spel-uchile/CAD_SUCHAI_II/Insterstage_panels/CAD/GomSpace CAD Disclaimer.pdf

© 2015 Gomspace Aps | 1

CAD Model Disclaimer

This

is

an

official

CAD

model

prepared

by

GomSpace

for

customer

use

in

an

early
NanoSatellite

design

phase.

The

presented

CAD

models

depict

a

specific
configuration

and

production

batch

of

the

specific

product

and

should

be

used

with
care.

GomSpace

accepts no

liability

for

the

content

of

the

CAD

models

publicly
available,

or

for

the

consequences

of

specific

implementation

or

use

of

the

CAD
models.

The

user

of

the

CAD

model

holds

responsibility

for

use

of

all

CAD

models
from

GomSpace

website,

regardless

of

the

support

provided

by

GomSpace

staff

on

a
regular

support

basis.

GomSpace

reserves

the

right

to

update

hardware

on

any
system

and

not

update

the

CAD

model

with

changes

immediately.

The

company
accepts

no

liability

for

faulty

design

work

done

based

on

the

CAD

models
downloaded

from

the

website.

For

more

information

contact

GomSpace

at

Info@gomspace.com
