spel-uchile/CAD_SUCHAI_II/CAD_Cubesat_3U.pdf

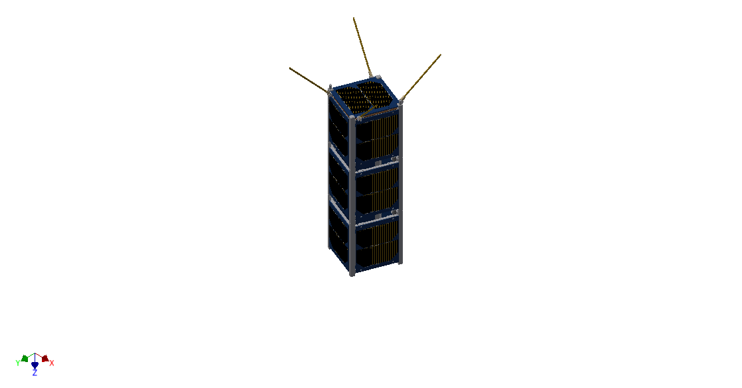
[picture p1: page 1]
