spel-uchile/CAD_SUCHAI_II/Structure/CAD/3U STS Export.jpg

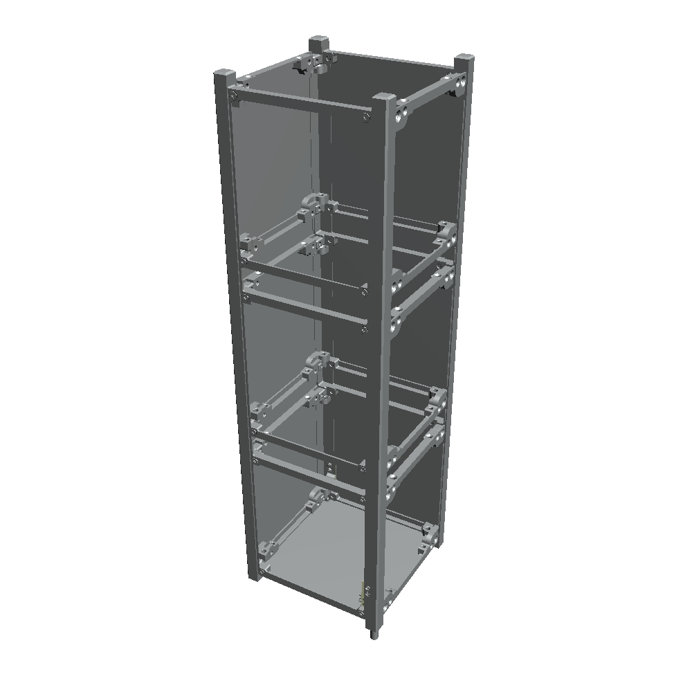
Structure/CAD/3U STS Export.jpg
