spel-uchile/CAD_SUCHAI_II/Insterstage_panels/CAD/GOMX-Interstage-B.stp

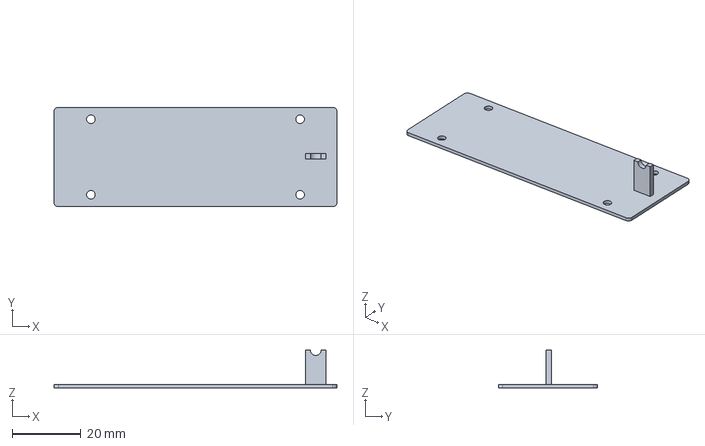
[picture p3: CAD file, 2017-08-24]
Insterstage_panels/CAD/GOMX-Interstage-B.stp
82.5 x 29.0 x 11.0 mm
