spel-uchile/CAD_SUCHAI_II/Nanopower_BP4/CAD/bp4-2.0.stp

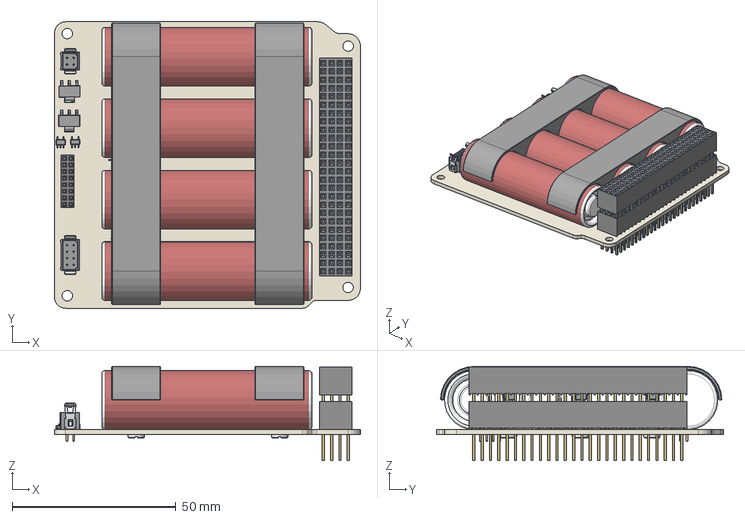
[picture p5: CAD file, 2017-08-24]
Nanopower_BP4/CAD/bp4-2.0.stp
93.4 x 87.4 x 28.7 mm
