spel-uchile/CAD_SUCHAI_II/Structure_1U/ISIS CubeSat STS PC104 Skeleton.stp

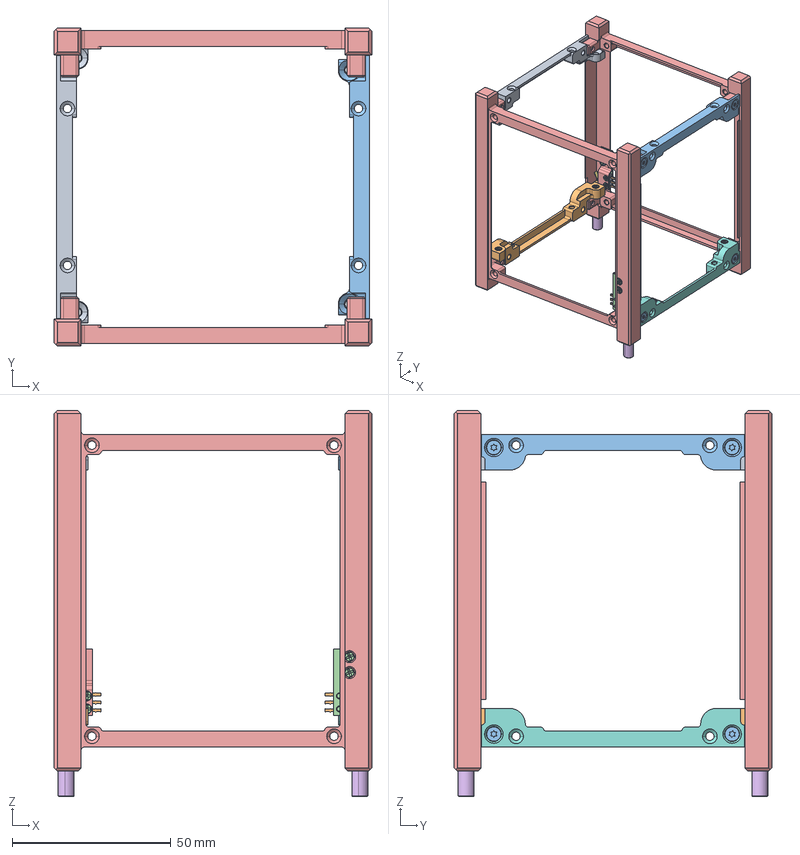
[picture p7: CAD file, 2017-08-24]
Structure_1U/ISIS CubeSat STS PC104 Skeleton.stp
100.0 x 100.0 x 121.5 mm
KILL_SWITCH_BODY x 2
KILL_SWITCH_PINS x 2
SCREW_M2_5X6 x 8
BRACKET_KS_007B x 2
BRACKET_KS_007A x 2
BUSJE_001 x 2
KILL_SWITCH_LEVER x 2
KILL_SWITCH_SWITCH x 2
SPRING_02 x 2
KILL_SWITCH_PIN x 2
NUT_M1_6 x 4
SCREW_M1_6X4 x 8
SIDE_FRAME_007 x 2
HELICOIL_M3_1_5D x 4
REVD_02-1_RIB_D
REVE_02-1_RIB_E
REVE_02-1_RIB_C
REVD_02-1_RIB_F
