spel-uchile/CAD_SUCHAI_II/Insterstage_panels/CAD/GOMX-Interstage-A.stp

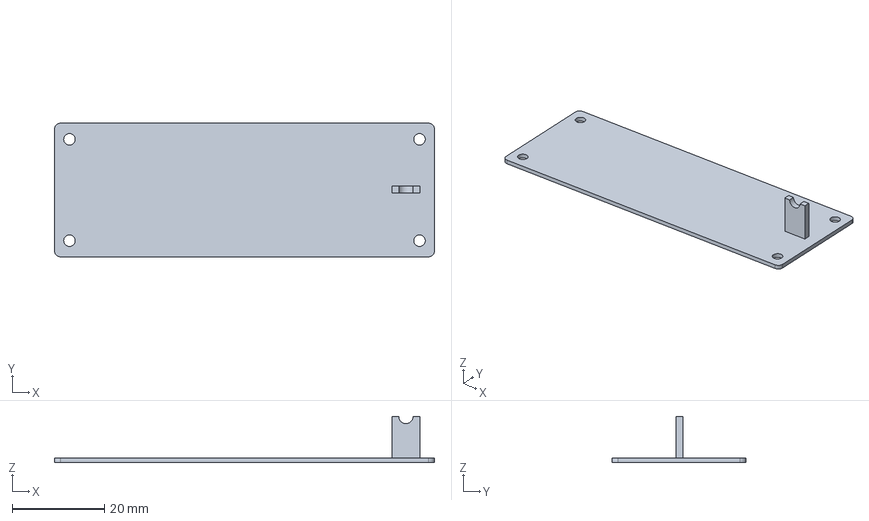
[picture p8: CAD file, 2017-08-24]
Insterstage_panels/CAD/GOMX-Interstage-A.stp
82.5 x 29.0 x 10.0 mm
