spel-uchile/CAD_SUCHAI_II/Nanocom_ant430/CAD/Sub_NanoCom_ANT430.stp/nanocom-ant430-deployed.stp

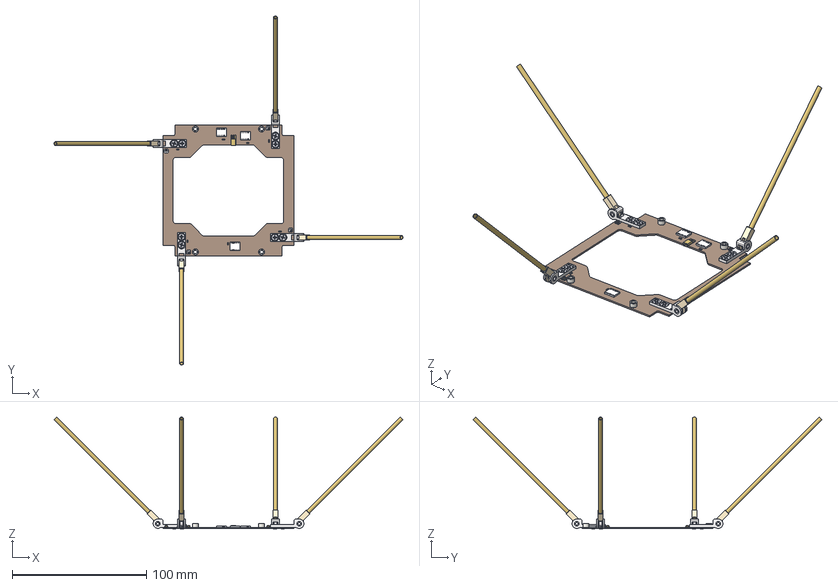
[picture p9: CAD file, 2017-08-24]
Nanocom_ant430/CAD/Sub_NanoCom_ANT430.stp/nanocom-ant430-deployed.stp
260.2 x 260.2 x 83.5 mm
panel-top
antenna-bracket-top-2 x 4
antenna-fork-top-1 x 4
antenna-fork-top-bush x 4
antenna-100 x 4
DIN EN ISO 7046-1 H M2,5 x 6 - 4.8 - H x 4
DIN EN ISO 7046-1 H M2,5 x 6 - 4.8 - H_1 x 4
hirose-ufl x 4
qba07 x 3
ssmcx-flat
R0603 x 7
2.5x4.5x3.0mm-spacer x 4
