spel-uchile/CAD_SUCHAI_II/Insterstage_panels/CAD/GOMX-Interstage-FPP.stp

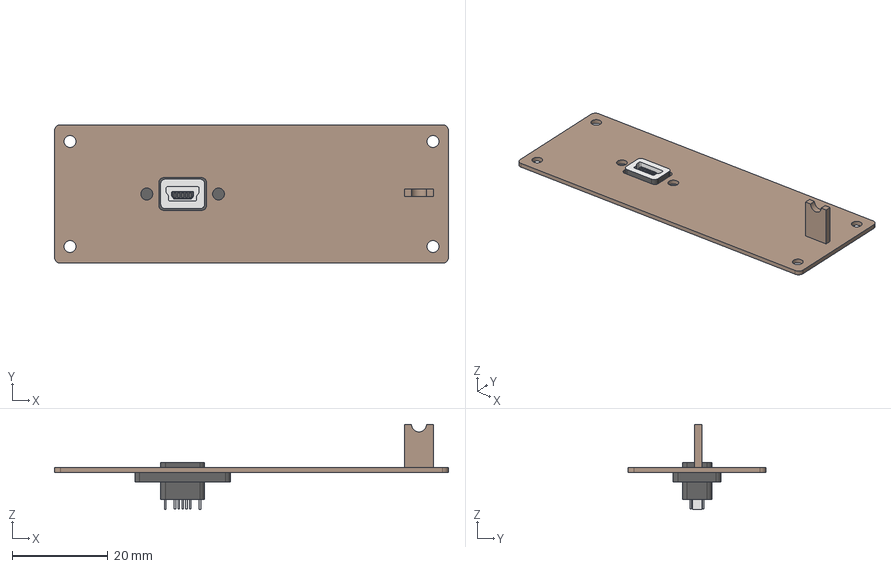
[picture p10: CAD file, 2017-08-24]
Insterstage_panels/CAD/GOMX-Interstage-FPP.stp
82.5 x 29.0 x 17.8 mm
fpp
User Library-USB-B-Vert-MINI
