spel-uchile/CAD_SUCHAI_II/(list of files, cad)

Other CAD files:
CAD_Cubesat_3U.iam
Insterstage_panels/CAD/GOMX-Interstage-A.ipt
Insterstage_panels/CAD/GOMX-Interstage-B.ipt
Insterstage_panels/CAD/GOMX-Interstage-FPP.iam
Insterstage_panels/CAD/OldVersions/GOMX-Interstage-FPP.0001.iam
Insterstage_panels/CAD/User Library-USB-B-Vert-MINI.ipt
Insterstage_panels/CAD/fpp.ipt
NanoDock/CAD/20140506-063843-14522585.ipt
NanoDock/CAD/457276448.iam
NanoDock/CAD/457276576.iam
NanoDock/CAD/457276704.iam
NanoDock/CAD/457276832.iam
NanoDock/CAD/457276960.iam
NanoDock/CAD/457277088.iam
NanoDock/CAD/457277216.iam
NanoDock/CAD/457277344.iam
NanoDock/CAD/457277600.iam
NanoDock/CAD/457277728.iam
NanoDock/CAD/457277856.iam
NanoDock/CAD/457277984.iam
NanoDock/CAD/457278112.iam
NanoDock/CAD/457278624.iam
NanoDock/CAD/457278752.iam
NanoDock/CAD/457278880.iam
NanoDock/CAD/532610471.iam
NanoDock/CAD/Board.ipt
NanoDock/CAD/C1.iam
NanoDock/CAD/C10.iam
NanoDock/CAD/C11.iam
NanoDock/CAD/C12.iam
NanoDock/CAD/C13.iam
NanoDock/CAD/C14.iam
NanoDock/CAD/C2.iam
NanoDock/CAD/C3.iam
NanoDock/CAD/C4.iam
NanoDock/CAD/C5.iam
NanoDock/CAD/C6.iam
NanoDock/CAD/C7.iam
NanoDock/CAD/C8.iam
NanoDock/CAD/C9.iam
NanoDock/CAD/Extruded.ipt
NanoDock/CAD/Extruded_1.ipt
NanoDock/CAD/Extruded_10.ipt
NanoDock/CAD/Extruded_11.ipt
NanoDock/CAD/Extruded_12.ipt
NanoDock/CAD/Extruded_13.ipt
NanoDock/CAD/Extruded_14.ipt
NanoDock/CAD/Extruded_15.ipt
NanoDock/CAD/Extruded_2.ipt
NanoDock/CAD/Extruded_3.ipt
NanoDock/CAD/Extruded_4.ipt
NanoDock/CAD/Extruded_5.ipt
NanoDock/CAD/Extruded_6.ipt
NanoDock/CAD/Extruded_7.ipt
NanoDock/CAD/Extruded_8.ipt
NanoDock/CAD/Extruded_9.ipt
NanoDock/CAD/H1.iam
NanoDock/CAD/H2.iam
NanoDock/CAD/L1.iam
NanoDock/CAD/L2.iam
NanoDock/CAD/Motherboard.iam
NanoDock/CAD/OldVersions/457276448.0002.iam
NanoDock/CAD/OldVersions/457276576.0002.iam
NanoDock/CAD/OldVersions/457276704.0002.iam
NanoDock/CAD/OldVersions/457276832.0002.iam
NanoDock/CAD/OldVersions/457276960.0002.iam
NanoDock/CAD/OldVersions/457277088.0002.iam
NanoDock/CAD/OldVersions/457277216.0002.iam
NanoDock/CAD/OldVersions/457277344.0002.iam
NanoDock/CAD/OldVersions/457277600.0002.iam
NanoDock/CAD/OldVersions/457277728.0002.iam
NanoDock/CAD/OldVersions/457277856.0002.iam
NanoDock/CAD/OldVersions/457277984.0002.iam
NanoDock/CAD/OldVersions/457278112.0002.iam
NanoDock/CAD/OldVersions/457278624.0002.iam
NanoDock/CAD/OldVersions/457278752.0002.iam
NanoDock/CAD/OldVersions/457278880.0002.iam
NanoDock/CAD/OldVersions/532610471.0002.iam
NanoDock/CAD/OldVersions/Board.0001.ipt
NanoDock/CAD/OldVersions/C1.0002.iam
NanoDock/CAD/OldVersions/C10.0002.iam
NanoDock/CAD/OldVersions/C11.0002.iam
NanoDock/CAD/OldVersions/C12.0002.iam
NanoDock/CAD/OldVersions/C13.0002.iam
NanoDock/CAD/OldVersions/C14.0002.iam
NanoDock/CAD/OldVersions/C2.0002.iam
NanoDock/CAD/OldVersions/C3.0002.iam
NanoDock/CAD/OldVersions/C4.0002.iam
NanoDock/CAD/OldVersions/C5.0002.iam
NanoDock/CAD/OldVersions/C6.0002.iam
NanoDock/CAD/OldVersions/C7.0002.iam
NanoDock/CAD/OldVersions/C8.0002.iam
NanoDock/CAD/OldVersions/C9.0002.iam
NanoDock/CAD/OldVersions/H1.0002.iam
NanoDock/CAD/OldVersions/H2.0002.iam
NanoDock/CAD/OldVersions/L1.0002.iam
NanoDock/CAD/OldVersions/L2.0002.iam
NanoDock/CAD/OldVersions/Motherboard.0002.iam
NanoDock/CAD/OldVersions/P1.0002.iam
NanoDock/CAD/OldVersions/P2.0002.iam
NanoDock/CAD/OldVersions/P3.0002.iam
NanoDock/CAD/OldVersions/P4.0002.iam
NanoDock/CAD/OldVersions/R1.0002.iam
NanoDock/CAD/OldVersions/R10.0002.iam
NanoDock/CAD/OldVersions/R11.0002.iam
NanoDock/CAD/OldVersions/R12.0002.iam
NanoDock/CAD/OldVersions/R13.0002.iam
NanoDock/CAD/OldVersions/R14.0002.iam
NanoDock/CAD/OldVersions/R15.0002.iam
NanoDock/CAD/OldVersions/R16.0002.iam
NanoDock/CAD/OldVersions/R17.0002.iam
NanoDock/CAD/OldVersions/R18.0002.iam
NanoDock/CAD/OldVersions/R19.0002.iam
NanoDock/CAD/OldVersions/R2.0002.iam
NanoDock/CAD/OldVersions/R20.0002.iam
NanoDock/CAD/OldVersions/R21.0002.iam
NanoDock/CAD/OldVersions/R22.0002.iam
NanoDock/CAD/OldVersions/R23.0002.iam
NanoDock/CAD/OldVersions/R24.0002.iam
NanoDock/CAD/OldVersions/R25.0002.iam
NanoDock/CAD/OldVersions/R26.0002.iam
NanoDock/CAD/OldVersions/R27.0002.iam
NanoDock/CAD/OldVersions/R28.0002.iam
NanoDock/CAD/OldVersions/R29.0002.iam
NanoDock/CAD/OldVersions/R3.0002.iam
NanoDock/CAD/OldVersions/R30.0002.iam
NanoDock/CAD/OldVersions/R31.0002.iam
NanoDock/CAD/OldVersions/R32.0002.iam
NanoDock/CAD/OldVersions/R33.0002.iam
NanoDock/CAD/OldVersions/R34.0002.iam
NanoDock/CAD/OldVersions/R35.0002.iam
NanoDock/CAD/OldVersions/R36.0002.iam
NanoDock/CAD/OldVersions/R37.0002.iam
NanoDock/CAD/OldVersions/R38.0002.iam
NanoDock/CAD/OldVersions/R39.0002.iam
NanoDock/CAD/OldVersions/R4.0002.iam
NanoDock/CAD/OldVersions/R40.0002.iam
NanoDock/CAD/OldVersions/R41.0002.iam
NanoDock/CAD/OldVersions/R42.0002.iam
NanoDock/CAD/OldVersions/R43.0002.iam
NanoDock/CAD/OldVersions/R44.0002.iam
NanoDock/CAD/OldVersions/R45.0002.iam
NanoDock/CAD/OldVersions/R46.0002.iam
NanoDock/CAD/OldVersions/R47.0002.iam
NanoDock/CAD/OldVersions/R48.0002.iam
NanoDock/CAD/OldVersions/R49.0002.iam
NanoDock/CAD/OldVersions/R5.0002.iam
NanoDock/CAD/OldVersions/R50.0002.iam
NanoDock/CAD/OldVersions/R51.0002.iam
NanoDock/CAD/OldVersions/R52.0002.iam
NanoDock/CAD/OldVersions/R53.0002.iam
NanoDock/CAD/OldVersions/R54.0002.iam
NanoDock/CAD/OldVersions/R55.0002.iam
NanoDock/CAD/OldVersions/R56.0002.iam
NanoDock/CAD/OldVersions/R57.0002.iam
NanoDock/CAD/OldVersions/R58.0002.iam
NanoDock/CAD/OldVersions/R59.0002.iam
NanoDock/CAD/OldVersions/R6.0002.iam
NanoDock/CAD/OldVersions/R60.0002.iam
NanoDock/CAD/OldVersions/R61.0002.iam
NanoDock/CAD/OldVersions/R62.0002.iam
NanoDock/CAD/OldVersions/R63.0002.iam
NanoDock/CAD/OldVersions/R64.0002.iam
NanoDock/CAD/OldVersions/R65.0002.iam
NanoDock/CAD/OldVersions/R66.0002.iam
NanoDock/CAD/OldVersions/R67.0002.iam
NanoDock/CAD/OldVersions/R68.0002.iam
NanoDock/CAD/OldVersions/R69.0002.iam
NanoDock/CAD/OldVersions/R7.0002.iam
NanoDock/CAD/OldVersions/R70.0002.iam
NanoDock/CAD/OldVersions/R71.0002.iam
NanoDock/CAD/OldVersions/R72.0002.iam
NanoDock/CAD/OldVersions/R73.0002.iam
NanoDock/CAD/OldVersions/R74.0002.iam
NanoDock/CAD/OldVersions/R75.0002.iam
NanoDock/CAD/OldVersions/R76.0002.iam
NanoDock/CAD/OldVersions/R77.0002.iam
NanoDock/CAD/OldVersions/R78.0002.iam
NanoDock/CAD/OldVersions/R79.0002.iam
NanoDock/CAD/OldVersions/R8.0002.iam
NanoDock/CAD/OldVersions/R9.0002.iam
NanoDock/CAD/OldVersions/U3.0002.iam
NanoDock/CAD/OldVersions/USB1.0002.iam
NanoDock/CAD/OldVersions/X1.0002.iam
NanoDock/CAD/OldVersions/X2.0002.iam
NanoDock/CAD/OldVersions/X3.0002.iam
NanoDock/CAD/OldVersions/X4.0002.iam
NanoDock/CAD/OldVersions/X5.0002.iam
NanoDock/CAD/OldVersions/motherboard-3_PEM.0002.iam
NanoDock/CAD/OldVersions/picoblade-8.0002.iam
NanoDock/CAD/Open CASCADE STEP translator 6.2 62.108.1.1.ipt
NanoDock/CAD/Open CASCADE STEP translator 6.2 62.63.1.1.ipt
NanoDock/CAD/P1.iam
NanoDock/CAD/P2.iam
NanoDock/CAD/P3.iam
NanoDock/CAD/P4.iam
NanoDock/CAD/R1.iam
NanoDock/CAD/R10.iam
NanoDock/CAD/R11.iam
NanoDock/CAD/R12.iam
NanoDock/CAD/R13.iam
NanoDock/CAD/R14.iam
NanoDock/CAD/R15.iam
NanoDock/CAD/R16.iam
NanoDock/CAD/R17.iam
NanoDock/CAD/R18.iam
NanoDock/CAD/R19.iam
NanoDock/CAD/R2.iam
NanoDock/CAD/R20.iam
NanoDock/CAD/R21.iam
NanoDock/CAD/R22.iam
NanoDock/CAD/R23.iam
NanoDock/CAD/R24.iam
NanoDock/CAD/R25.iam
NanoDock/CAD/R26.iam
NanoDock/CAD/R27.iam
NanoDock/CAD/R28.iam
NanoDock/CAD/R29.iam
NanoDock/CAD/R3.iam
NanoDock/CAD/R30.iam
NanoDock/CAD/R31.iam
NanoDock/CAD/R32.iam
NanoDock/CAD/R33.iam
NanoDock/CAD/R34.iam
NanoDock/CAD/R35.iam
NanoDock/CAD/R36.iam
NanoDock/CAD/R37.iam
NanoDock/CAD/R38.iam
NanoDock/CAD/R39.iam
NanoDock/CAD/R4.iam
NanoDock/CAD/R40.iam
NanoDock/CAD/R41.iam
NanoDock/CAD/R42.iam
NanoDock/CAD/R43.iam
NanoDock/CAD/R44.iam
NanoDock/CAD/R45.iam
NanoDock/CAD/R46.iam
NanoDock/CAD/R47.iam
NanoDock/CAD/R48.iam
NanoDock/CAD/R49.iam
NanoDock/CAD/R5.iam
NanoDock/CAD/R50.iam
NanoDock/CAD/R51.iam
NanoDock/CAD/R52.iam
NanoDock/CAD/R53.iam
NanoDock/CAD/R54.iam
NanoDock/CAD/R55.iam
NanoDock/CAD/R56.iam
NanoDock/CAD/R57.iam
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
